malipek/arduino-gm/(commit log)

2022-10-09 Schematic of system connections added to readme
2022-10-10 Update README.md
    I2C mode of OLED added in readme
2022-12-17 Added ground connected to Arduini pin
2022-12-29 Fix JSON data from arduino, add lambda for DynamoDB
    [arduino-gm.ino]
2022-12-30 Python serial listener on Arduino port
2023-08-24 Fixed param for CPM to uSv/h conversion
    [arduino-gm.ino]
2023-08-24 Fixed multipler parameter type (can be a fraction now)
    [arduino-gm.ino]
2023-09-01 pressure readings added
